Tinkerforge/evse-v3-bricklet/hardware/evse-v3-schematic.pdf

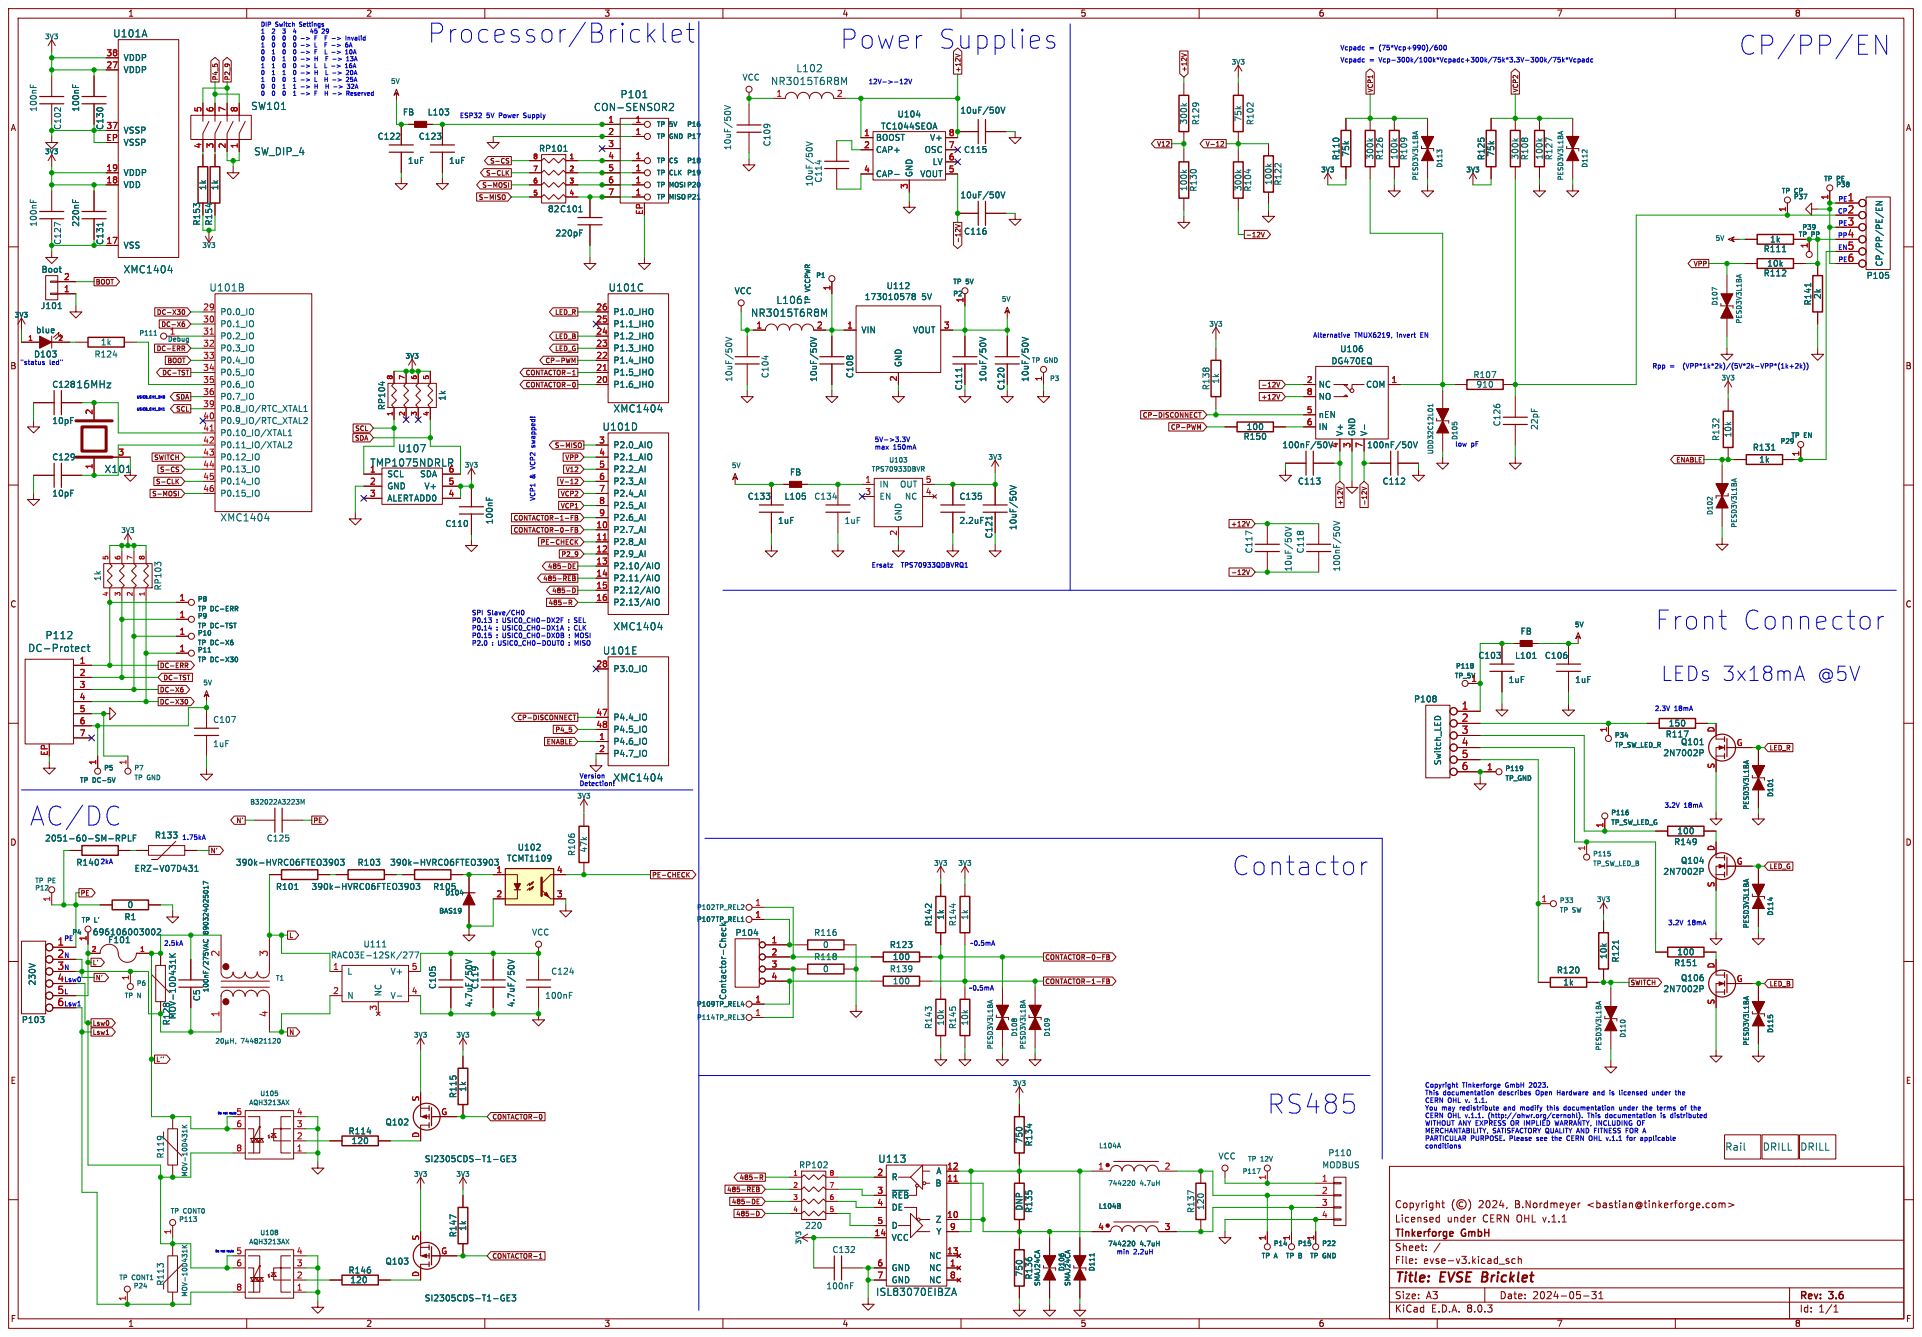
[picture p1: page 1]

VSS 17 VDD 18 VDDP 19 VDDP 27 VSSP 37 VDDP 38 VSSP EP

Vcpadc = Vcp-300k/100k*Vcpadc+300k/75k*3.3V-300k/75k*Vcpadc

5 RP104 1k 1 P9TP DC-TST 1 P8TP DC-ERR

P5 TP DC-5V 1 P112 DC-Protect 1

PARTICULAR PURPOSE. Please see the CERN OHL v.1.1 for applicable

Id: 1/1 Title: EVSE Bricklet File: evse-v3.kicad_sch Sheet: / Tinkerforge GmbH
