Tinkerforge/evse-v3-bricklet/(commit log)

2023-10-27 initial init, version 3.2
    [evse-v3.kicad_pcb, evse-v3.kicad_sch]
2023-10-31 version 3.3: fix i2c pins
    [evse-v3.kicad_pcb, evse-v3.kicad_sch]
2023-11-02 change contactor check pe resistors 100->0 Ohm
    [evse-v3.kicad_pcb, evse-v3.kicad_sch]
2023-11-29 started with version 3.4
    * add cm choke, 100nF capacitor
    * Remove power connector
    * Optimize design
    * Remove mounting hole
    * Move and change fuse holder
    [evse-v3.kicad_pcb, evse-v3.kicad_sch]
2023-12-01 connector moved, fully routed
    [evse-v3.kicad_pcb]
2023-12-01 design improved
    [evse-v3.kicad_pcb]
2023-12-01 specify values
    [evse-v3.kicad_pcb, evse-v3.kicad_sch]
2023-12-04 specify part numbers
    [evse-v3.kicad_pcb, evse-v3.kicad_sch]
2023-12-19 version 3.5
    * add Y capacitor for N-PE
    * increase RS485 common choke value
    * improve CP layout, add TVS Diodes, enlarge footprints
    * swap VCP1 and VCP2 (improved routing)
    [evse-v3.kicad_pcb, evse-v3.kicad_sch]
2023-12-21 add n-pe varistor
    [evse-v3.kicad_pcb, evse-v3.kicad_sch]
2023-12-22 layout improvement
    [evse-v3.kicad_pcb, evse-v3.kicad_sch]
2023-12-27 version 3.5
    [evse-v3.kicad_pcb, evse-v3.kicad_sch]
2024-01-10 specify var
    [evse-v3.kicad_pcb]
2024-02-13 document DIP switch current settings
    [evse-v3.kicad_sch]
2024-02-14 change DIP Switch Settings, fix DIP Switch numbering
    [evse-v3.kicad_pcb, evse-v3.kicad_sch]
2024-02-16 label RS485 wires
    [evse-v3.kicad_pcb]
2024-02-22 change rs485 protection diodes (leakage current)
    [evse-v3.kicad_pcb, evse-v3.kicad_sch]
2024-05-24 change rs485 transceiver
    [evse-v3.kicad_pcb, evse-v3.kicad_sch]
2024-09-09 Add schematic as pdf
