Tinkerforge/evse-v3-bricklet/(notices)

Notices in the files:
hardware/evse-v3.kicad_pcb:
Licensed under CERN OHL v.1.1
Copyright (©) 2024, B.Nordmeyer
Copyright Tinkerforge GmbH 2024.
